kokkonisd/pression/Working sessions reports/20170329.odt

Compte rendu de la séance de projet 29/03/2017

Retirer le mapping des valeurs des capteurs dans le code de l'arduino.

Amélioration de la Tare et ajout d'une valeur minimale de "10" sur les capteurs lorsqu'ils sont au repos et non 0.

Permet de centrer le centre de gravité dans l'app et eviter les 0 bugués.

Redaction du rapport

Ajout de la documentation du logiciel (non écrite mais implémenté dans le programme PC)

Changement des fils des load sensors, remplacement par des plus grands et protection mécanique avec gaine thermo'.
