kokkonisd/pression/Working sessions reports/20170405.odt

Compte Rendu de la séance 05/04/2017:

Recherche des dimensions d'une plaque a poser entre les capteurs, le sol et la chaise. Dimensions retenues 65*65cm ou 60*60 cm à défaut.

Rédaction du rapport de projet.

Prise de photos pour le rapport de projet.
