kokkonisd/pression/Working sessions reports/20170322.odt

Compte-Rendu de la séance du 22/03/17

Pendant cette séance, on a fait un refactoring du code qui gère le chargement et l'enregistrement de la chaise : afin de pouvoir garder la même échelle en ce qui concerne la deadzone, on a introduit une nouvelle variable appelée "deadzone ratio", qui varie de 0 à 1 et représente la fraction de l'aire de la chaise occupée par la deadzone. On a modifié le code pour mettre à jour ce changement et on a vérifié que les méthodes save/load marchent bien sur l'application PC.

En ce qui concerne l'application Android, on a implémenté la fonction chargement de la chaise, en vérifiant que l'application peut donc charger des fichiers "chaise" crées par l'application PC (comme ça tous les fichier "chaise" sont interchangeables). Puis, on a ajouté un bouton "tare", pour pouvoir avoir accès à la fonction "tare" de l'Arduino par l'application Android.

Au niveau de l'Arduino, on a implémenté la fonction "tare" pour l'USB et le Bluetooth, en vérifiant qu'elle marche bien sur toutes les plateformes (PC & téléphone portable).

On a aussi commencé a travailler sur les supports des capteurs pour les placer sous une chaise; on est en train de construire un prototype sur AutoCAD. On a déjà fabriqué des petit support en bois MDF qui permettent de poser une chaise sur les capteurs.

Finalement, on a testé l'application en mettant une chaise sur le matériau, et en posant un sac sur la chaise. On a constaté que les capteurs et l'application répondent bien aux changements de la position du sac, et qu'on obtient bien le résultat voulu.

Objectifs pour la prochaine séance:

- Ajuster les paramètres des capteurs dans l'Arduino (mapping des valeurs)

- Tester la chaise avec une personne
