kokkonisd/pression/Working sessions reports/20170315.odt

Compte rendu de séance de projet 8 15/03/2017:

Pendant cette séance, on a réussi à connecter le dernier amplificateur au load sensor et à l'Arduino; on a testé les quatre load sensors ensemble et ils marchent bien avec le logiciel.

On a aussi corrigé quelques bugs dans les méthodes d'enregistrement et de chargement de l'objet Chaise, mais comme la sérialization d'un objet Java avec l'application PC ne permet pas de charger l'objet dans l'application Android, on a decidé de changer le protocole d'enregistrement : les objets Chaise vont être sauvegardés dans des fichiers .txt, ce qui permet de les charger partout.

Finalement, on a mis à jour le code de l'Arduino pour prendre en compte le dernier capteur et pour négliger les valeurs négatives (bruit) envoyés par les capteurs.
