kokkonisd/pression/Working sessions reports/20170215.odt

Compte rendu scéance 6 15/02/2017

Ajout des fonctionnalités de deadzone et sauvegarde et chargement de l'objet chaise. A demandé beaucoup de reflexion sur tableau blanc.
