kokkonisd/pression/Working sessions reports/20170207.odt

Compte rendu séance de projet 5 07/02/2017

1. Ajoût de la fonction de paramétrage d'une "deadzone" dans laquelle on dit que la posture assise est correcte. Un cercle vert indique la zone de comfort. Les informations à propos de cette zone sont stockés dans l'objet Chaise conçu pour effectuer tout les calculs.
2. Corrections de bugs dans l'application Android. Amélioration des performances.
3. Modification du nom bluetooth du shield Arduino (BTProjetDI6)

Objectif pour la prochaine séance:

Terminer l'implémentation du paramétrage de la deadzone et implémentation de la notification en cas de sortie de la deadzone.

Améliorer l'interface graphique de l'application bluetooth.

Si le temps le permet:

Améliorer l'autonomie de l'arduino (mise en veille, coupure du bluetooth...)
