kokkonisd/pression/Working sessions reports/20170125.odt

Compte rendu séance de projet 3 25012017

1. Visite du PAF de 9h à 9h30 OK
2. Démontage d'une balance électronique pour étudier les capteurs de charges (load sensors) OK
3. Mesure des valeurs de resistances du capteur de charge => 1kOhm OK
4. Fabrication d'un pont WheatStone avec un capteur de force et 2 resistances d'1 kOhm KO (impossible de verifier le fonctionnement sans amplificateur, oscillo et voltmetres pas assez précis pour mesure la ddp du pont wheatstone)
5. Modification du code de l'arduino pour permettre la reception de données via le port série (permettra d'envoyer des commandes pour contrôler l'arduino depuis le programme sur PC ou Android) OK
6. Ajout d'un shield bluetooth OK
7. Modification du code de l'arduino pour prendre en charge le Shield bluetooth OK
8. Transmission des données via Bluetooth vers l'ordinateur OK
9. Alimentation de l'arduino + shield via Power bank USB OK (autonomie énergétique et communication sans fils)

Objectif prochaine séance:

Démarrage du développement d'une APP android pour afficher la position du centre de gravité sur son smartphone

Amelioration du code du PC pour lancer la connexion via bluetooth depuis un Thread et eviter de freezer le main Thread

Ajouter la fonctionnalité de paramétrage de la chaise utilisé dans l'interface PC

Ajouter une fonction de sauvegarde de la position du centre de gravité optimale pour detecter la mauvaise assise en cas de déplacement de celui ci.
