kokkonisd/pression/Working sessions reports/20170118.odt

Compte rendu de la séance 2

Pendant la séance du 18/01/2017 nous avons fini la programmation d'une interface graphique qui permet la visualisation du centre de gravité d'une chaise à quatre pieds. Bien qu’on ait un seul FSR (senseur), on a pu tester l'application en soudant trois potentiomètres et en les connectant à l'Arduino, pour simuler ainsi les quatre pieds de la chaise. Puis, on a mis une vidéo sur GitHub (https://github.com/kokkonisd/pression/blob/master/Visualisation%20Program%20connected%20to%20Arduino.mp4) permettant d'envisager le changement de la position du centre de gravité de la chaise en fonction des valeurs du senseur et des potentiomètres.

Nous avons aussi fixé un protocole de transmission, suivant lequel l'Arduino transmet les valeurs des senseurs 1 à 4, séparés par un point-virgule (";"). Puis on a programmé en Java un parser, qui transforme la chaîne des caractères qu'on reçoit par l'Arduino en un tableau d’entiers qu'on peut exploiter pour calculer la position du centre de gravité.

En outre, l'interface graphique nous permet aussi de choisir un port de communication et de l'activer pour communiquer avec l'Arduino.

Nos objectifs sont désormais:

a. Améliorer l'interface graphique; on pourrait éventuellement implémenter des fonctionnalités supplémentaires, comme la possibilité de pouvoir renter les dimensions d'une chaise, puis les sauvegarder, et donc éviter de faire entrer les mêmes données plusieurs fois, ou bien utiliser le logiciel avec des chaises différentes

b. Commencer à travailler avec la shield Bluetooth de l'Arduino, pour établir la communication des donnés par Bluetooth.
