kokkonisd/pression/Working sessions reports/20170111.odt

Compte rendu scéance 1

Nous avons installé l'IDE Arduino et les pilotes de la carte Arduino OK!

Mise en place d'un Github pour partager le code et le projet OK!

Test de contrôle LED intégrée à l'Arduino OK !

Acquisition de données du capteur de pression et affichage dans le moniteur serie OK !

Reception en JAVA des messages série émis par l'Arduino et reception des messages emis depuis JAVA par l'Arduino avec la l'API JserialComm OK!

Nous allons donc pouvoir développer une application PC permettant de visionner les valeurs des capteurs de pression. Elle permettra de calculer la position du centre de gravité et en déduire la qualité de l'assise par rapport a la position recommandée. Les calculs se feront à partir de l'empatement de la chaise et des valeurs données par les capteurs de force. L'interface utilisateur devrait permettre de visualiser la position du centre de gravité afin d'ajuster facilement l'assise.

Recherche de capteurs de pression utilisable sur une chaise:

-Capteur de pression 50kg pour pese personne avec amplificateur pour le connecter à l'arduino.
