kokkonisd/pression/photos/photos_arduino/IMG_6746.JPG

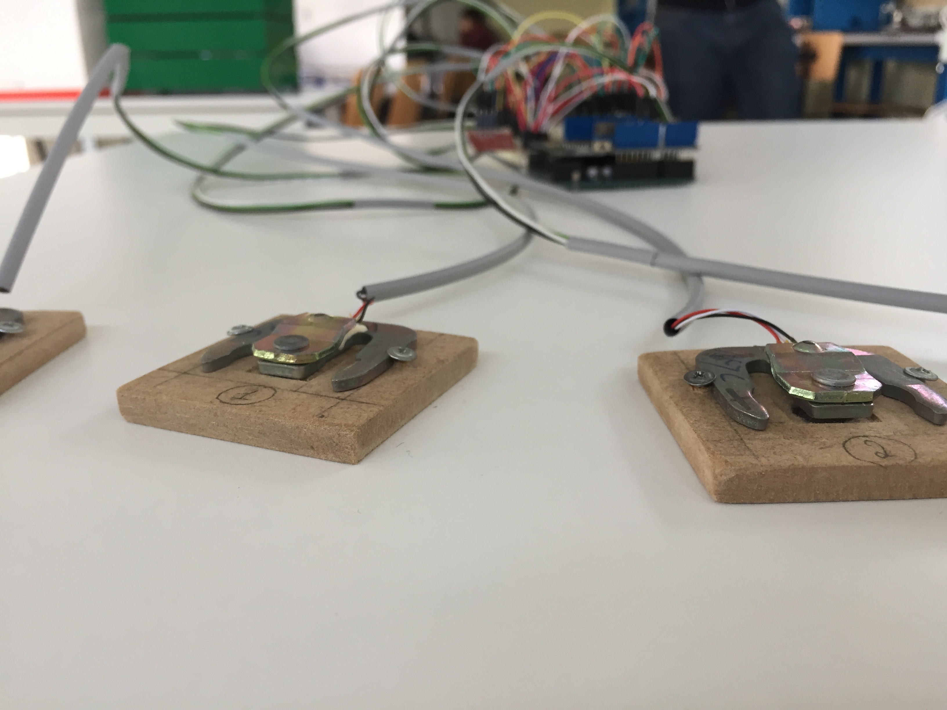
photos/photos_arduino/IMG_6746.JPG
