kokkonisd/pression/photos/photos_arduino/IMG_6747.JPG

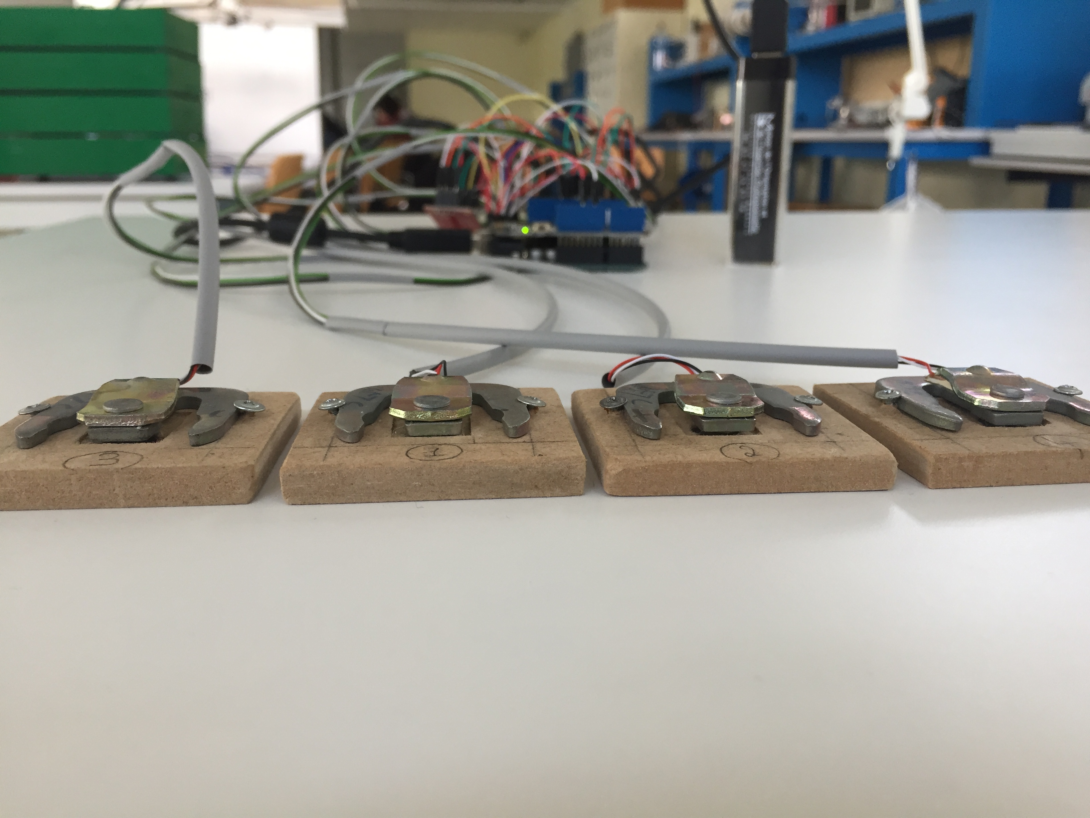
photos/photos_arduino/IMG_6747.JPG
