kokkonisd/pression/photos/photos_arduino/IMG_6750.JPG

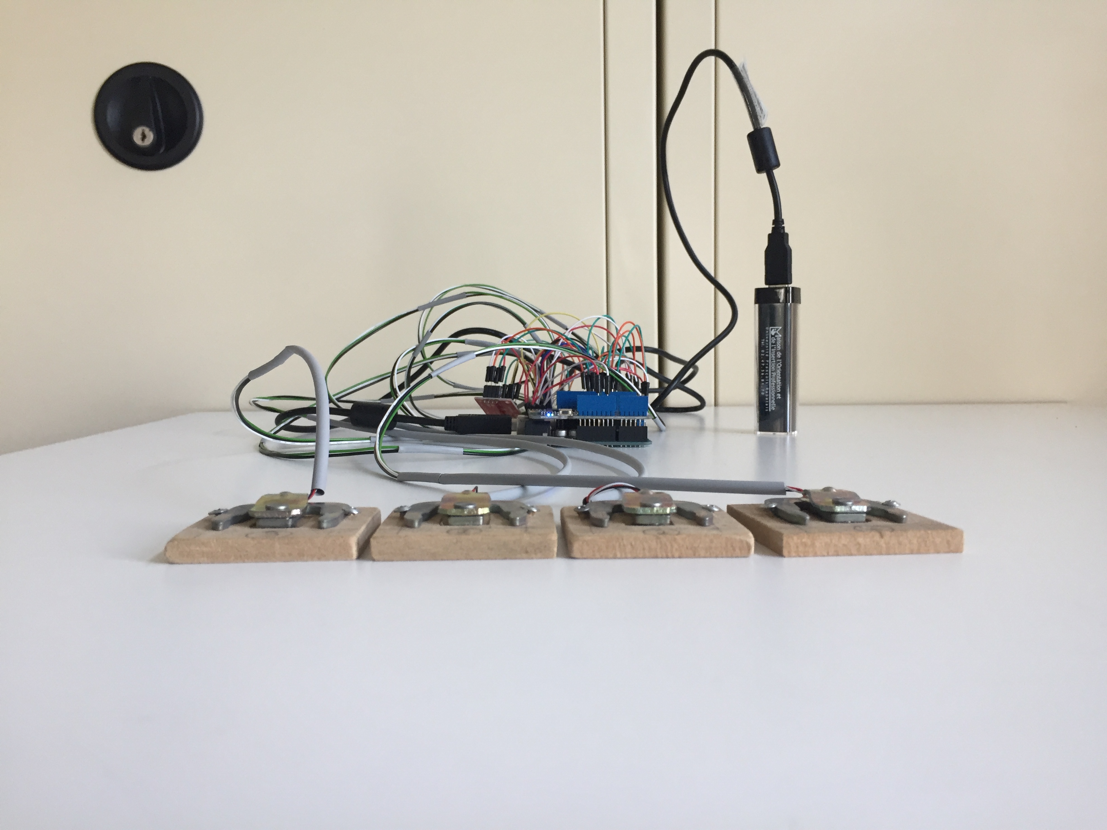
photos/photos_arduino/IMG_6750.JPG
