kokkonisd/pression/photos/photos_arduino/IMG_6751.JPG

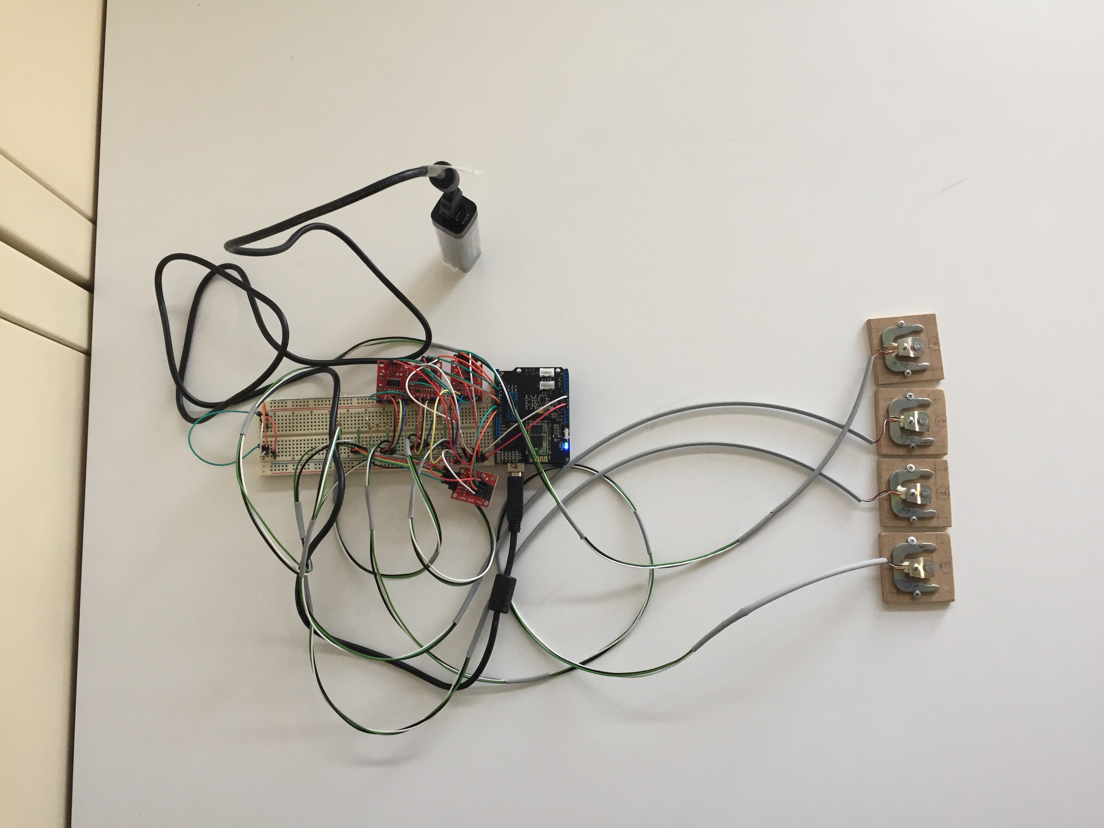
photos/photos_arduino/IMG_6751.JPG
