kokkonisd/pression/photos/photos_arduino/IMG_6752.JPG

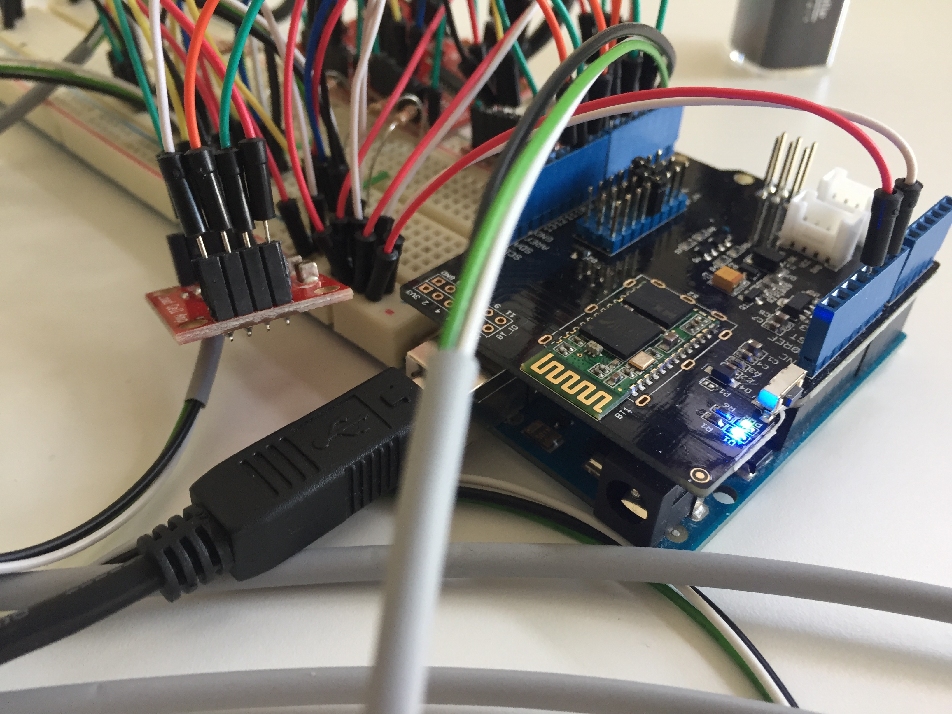
photos/photos_arduino/IMG_6752.JPG
