kokkonisd/pression/photos/photos_arduino/IMG_6755.JPG

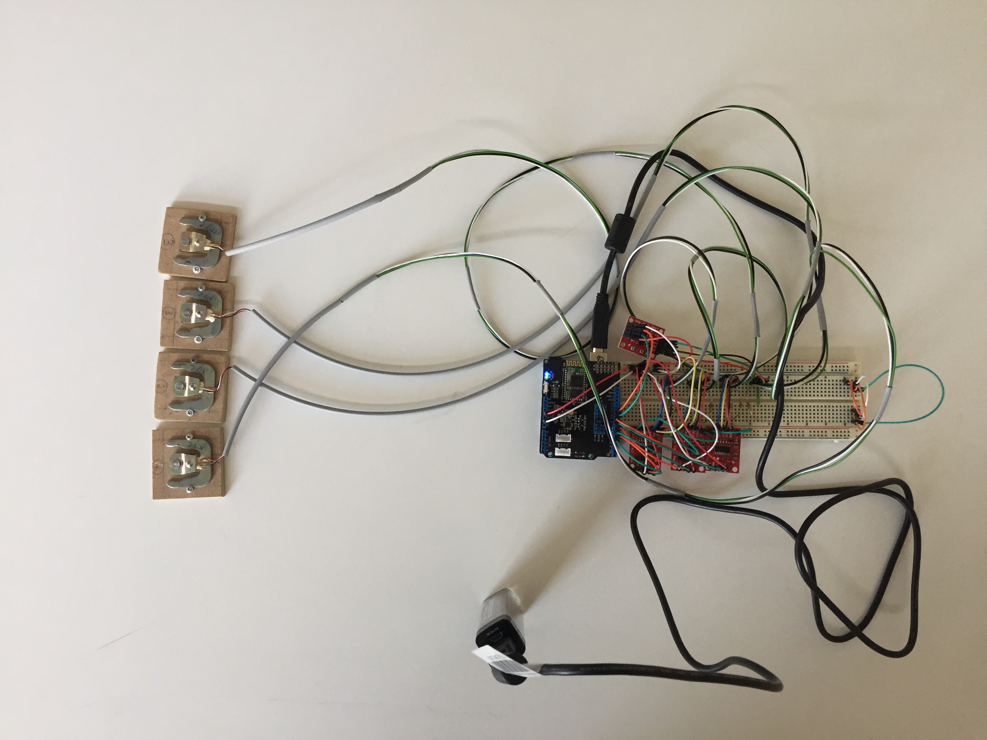
photos/photos_arduino/IMG_6755.JPG
