kokkonisd/pression/photos/photos_arduino/IMG_6756.JPG

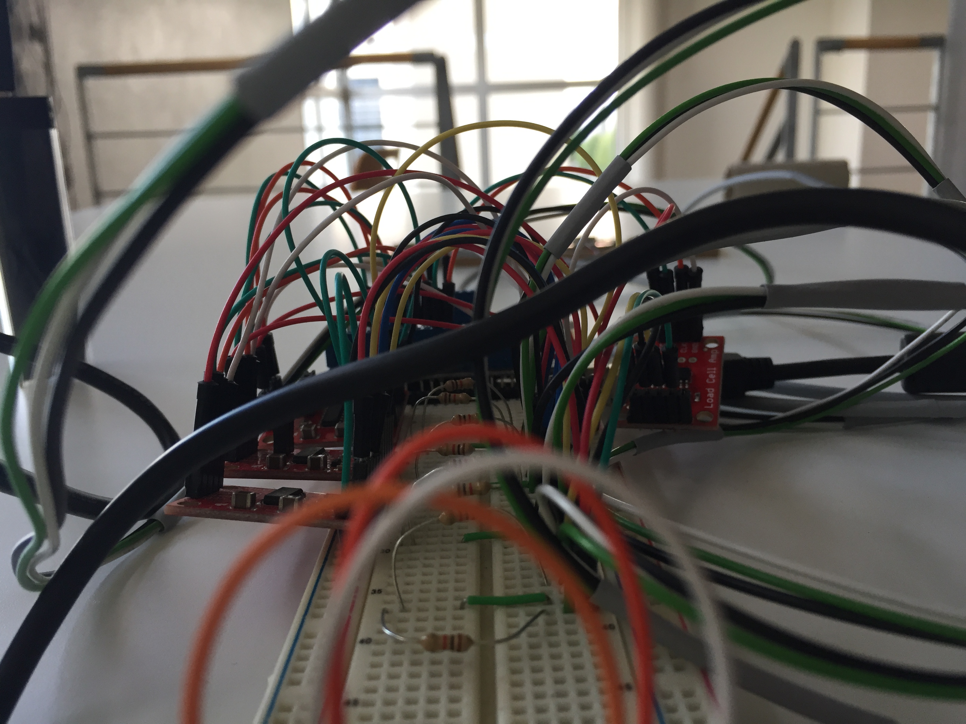
photos/photos_arduino/IMG_6756.JPG
