kokkonisd/pression/photos/photos_arduino/IMG_6757.JPG

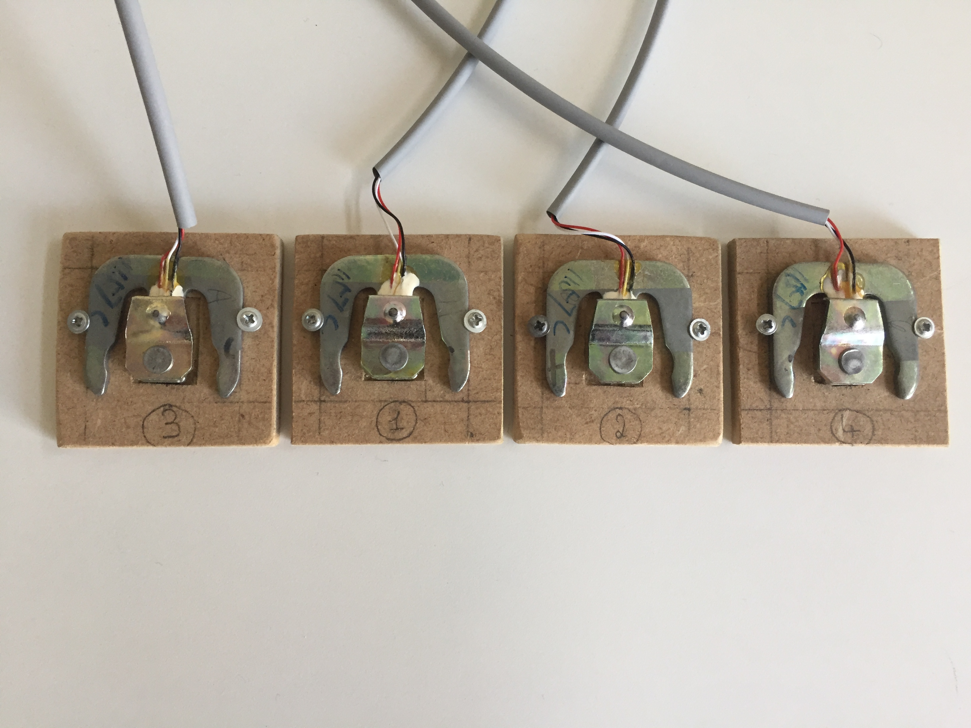
photos/photos_arduino/IMG_6757.JPG
