kokkonisd/pression/photos/photos_arduino/IMG_6758.JPG

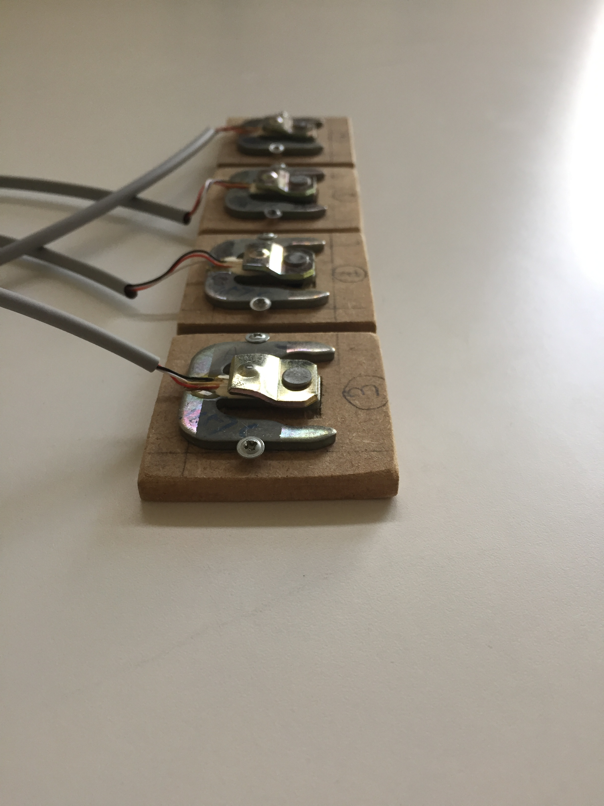
photos/photos_arduino/IMG_6758.JPG
