kokkonisd/pression/project.JPG

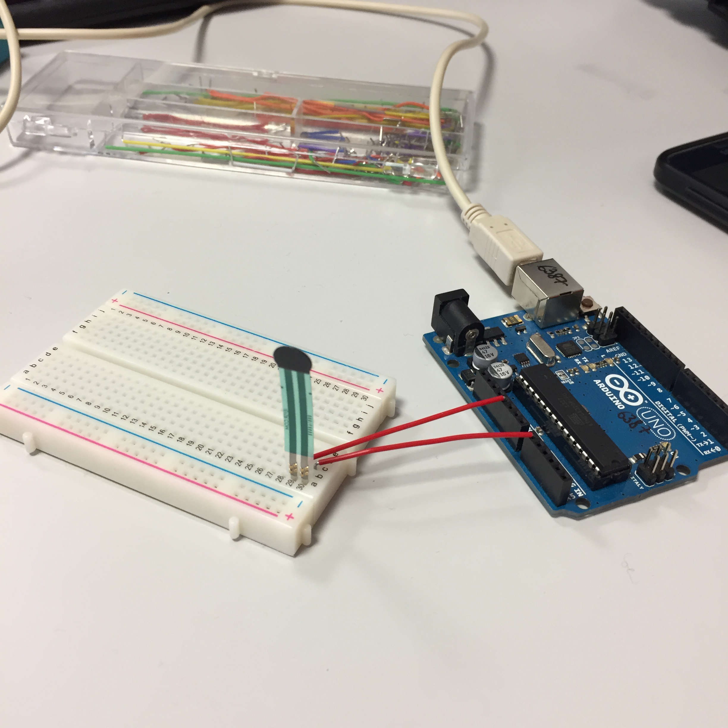
project.JPG
