kokkonisd/pression/Soutenance/images/Arduino_v1.jpg

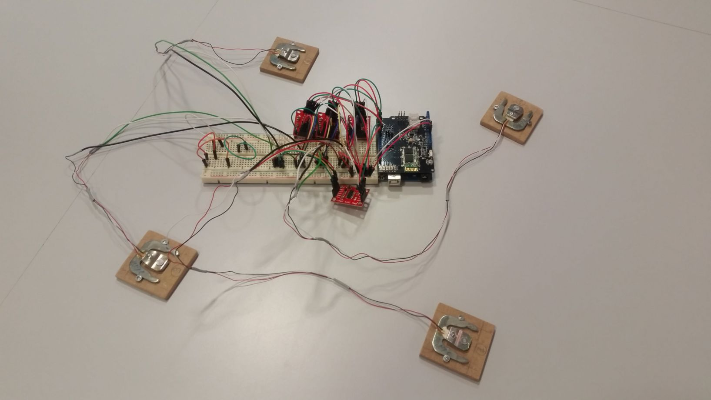
Soutenance/images/Arduino_v1.jpg
