kokkonisd/pression/Soutenance/images/Arduino_v1_bat.jpg

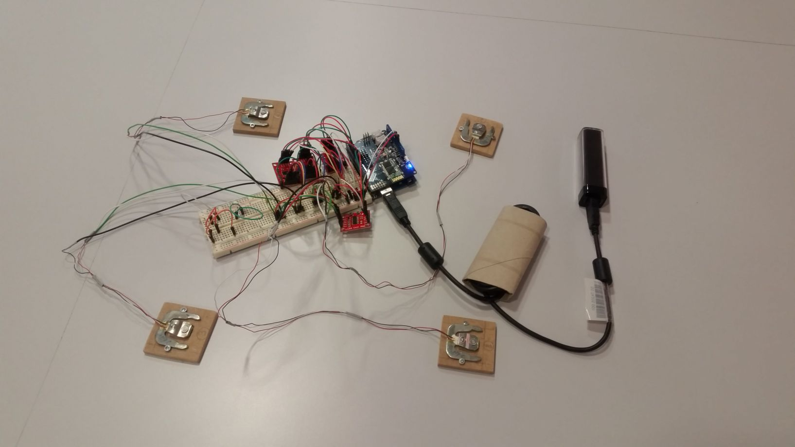
Soutenance/images/Arduino_v1_bat.jpg
