kokkonisd/pression/Soutenance/images/Arduino_v1_bat_ch.jpg

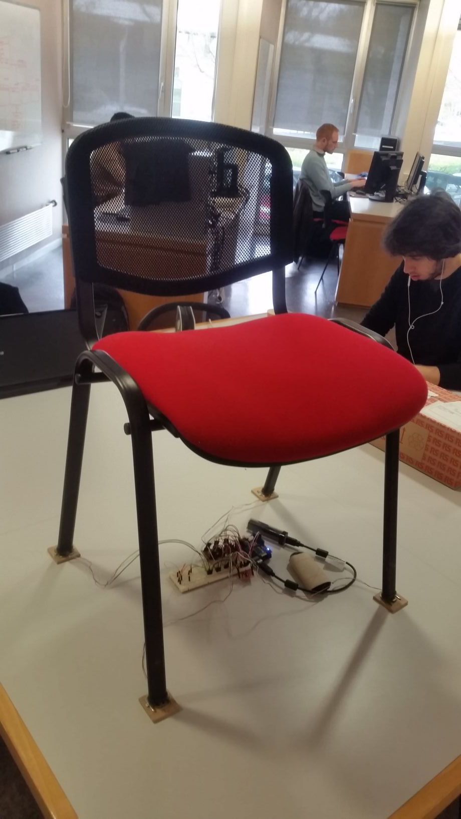
Soutenance/images/Arduino_v1_bat_ch.jpg
