kokkonisd/pression/Soutenance/images/jpanel1.PNG

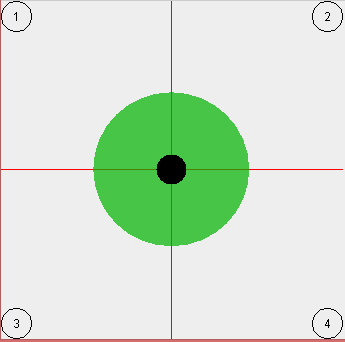
Soutenance/images/jpanel1.PNG
