kokkonisd/pression/Soutenance/images/jpanel3.PNG

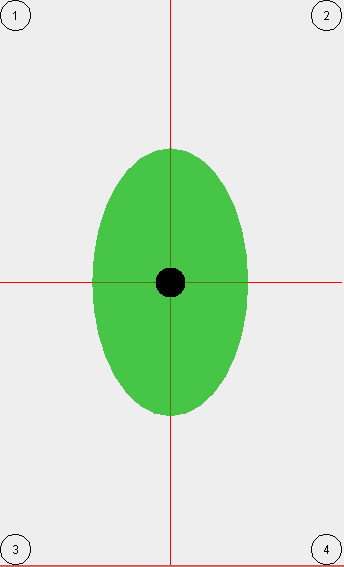
Soutenance/images/jpanel3.PNG
