kokkonisd/pression/Soutenance/images/mesure_de_consommation1bis.JPG

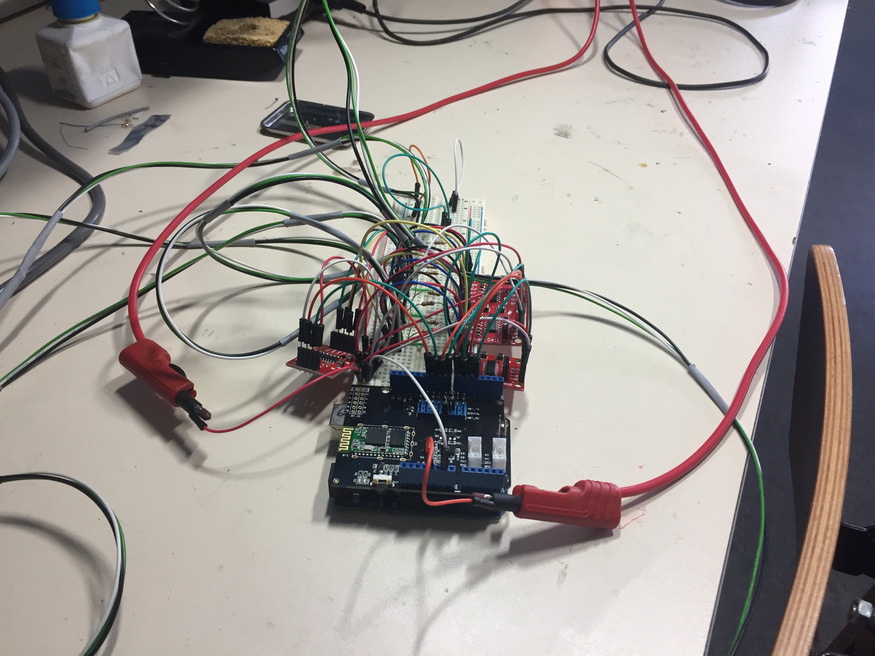
Soutenance/images/mesure_de_consommation1bis.JPG
