kokkonisd/pression/Soutenance/images/poster_1.jpg

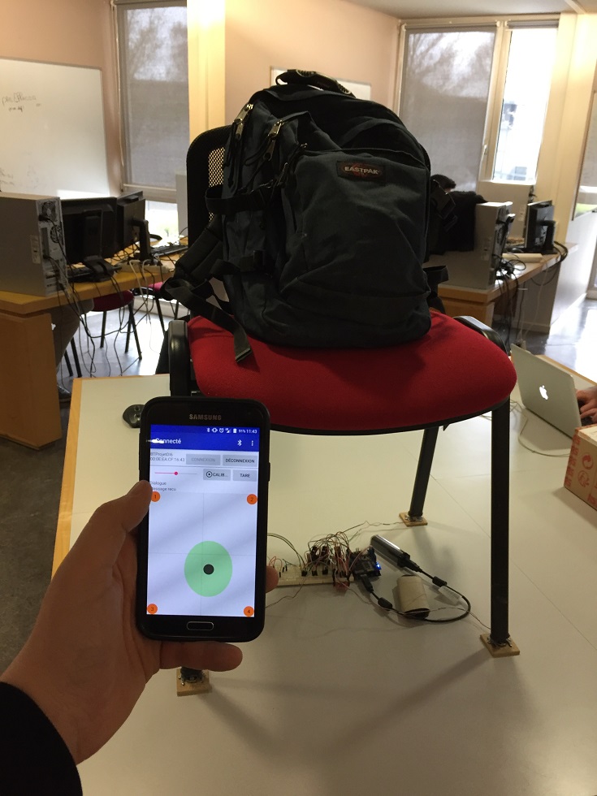
Soutenance/images/poster_1.jpg
