kokkonisd/pression/Soutenance/images/poster_2.jpg

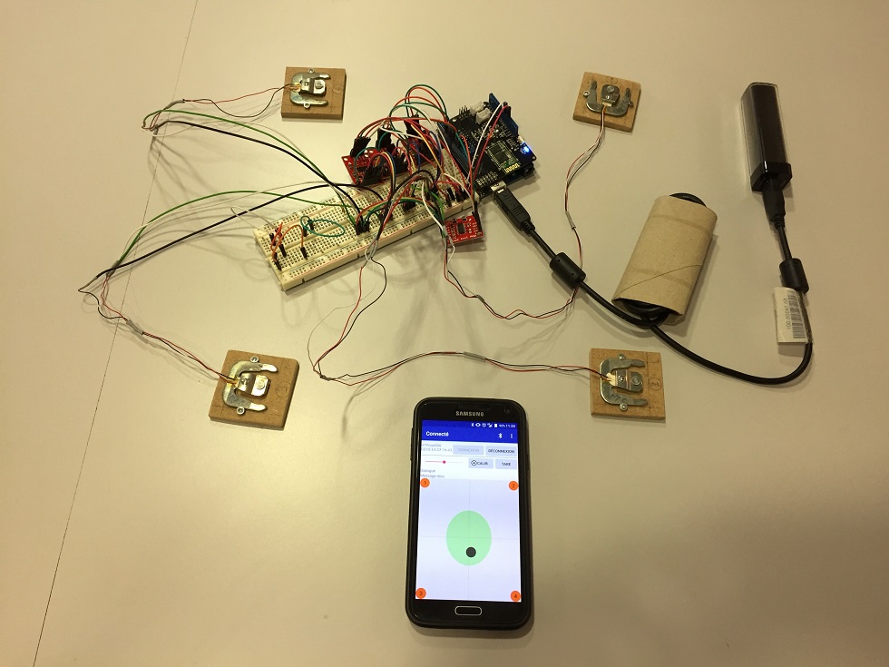
Soutenance/images/poster_2.jpg
