kokkonisd/pression/Soutenance/images/poster_3.JPG

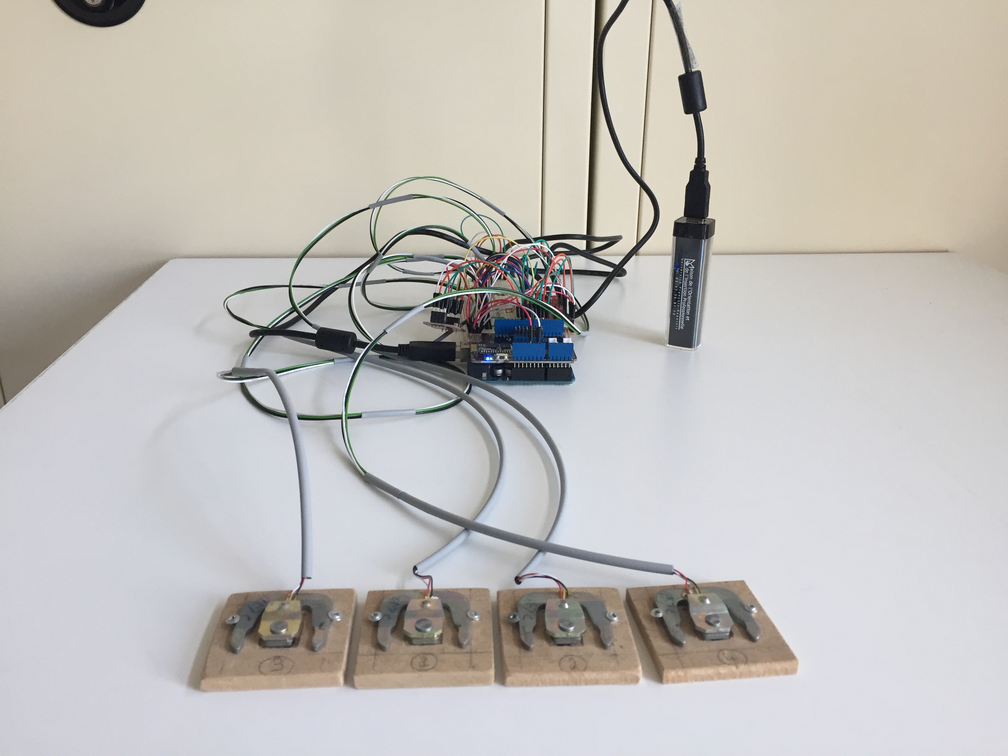
Soutenance/images/poster_3.JPG
