kokkonisd/pression/Soutenance/images/refs.png

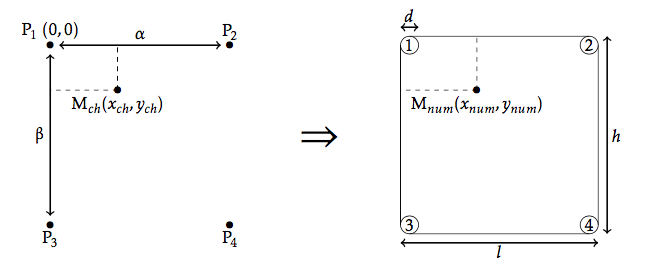
Soutenance/images/refs.png
