kokkonisd/pression/Soutenance/images/rxtx.jpg

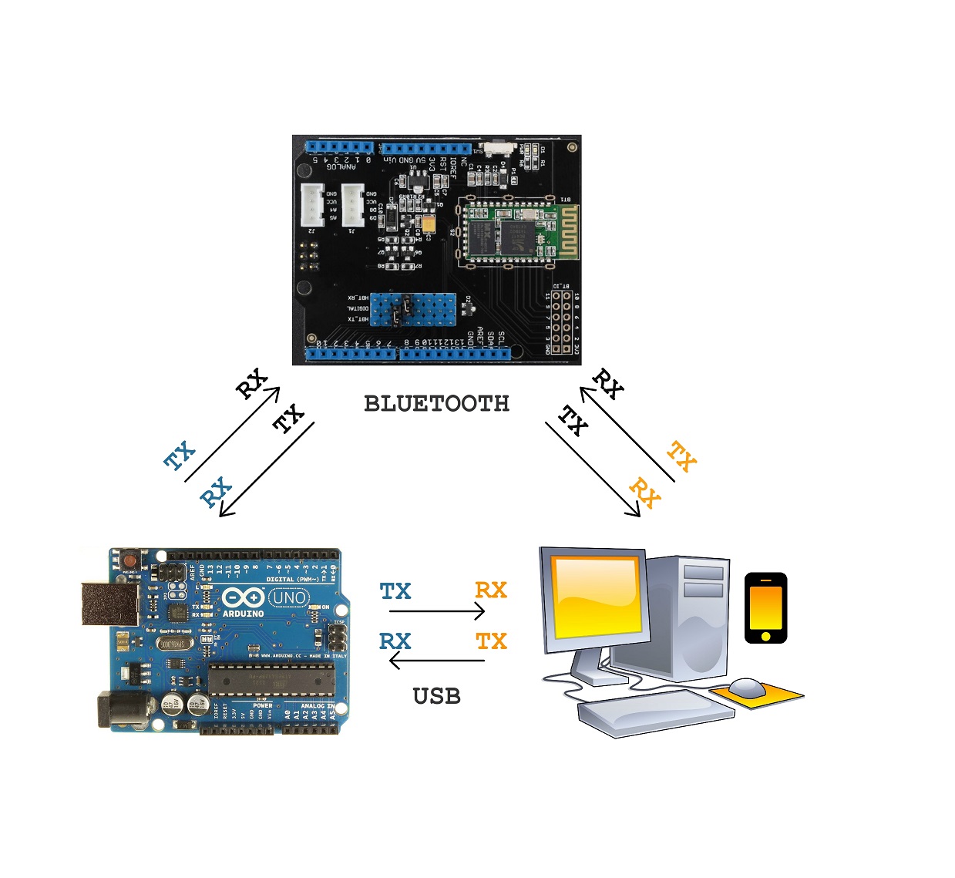
Soutenance/images/rxtx.jpg
