kokkonisd/pression/Soutenance/images/screenshot_android2.png

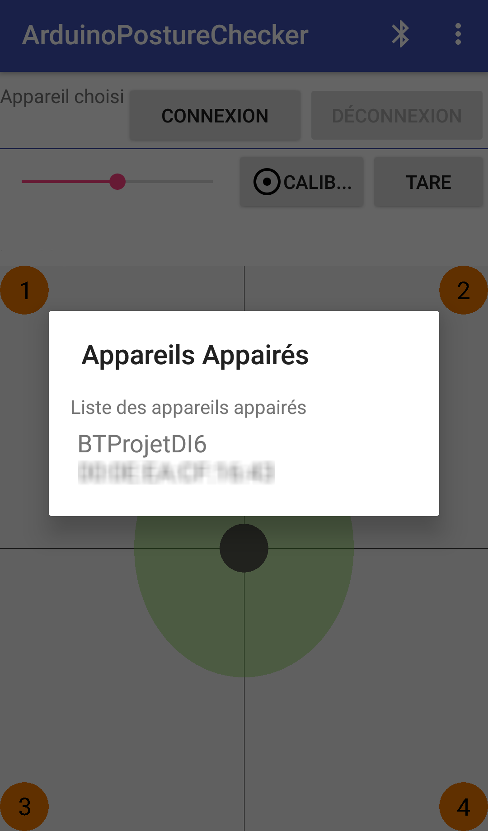
Soutenance/images/screenshot_android2.png
