kokkonisd/pression/Schematics and Datasheets/Config 1 one Load sensor arduino wiring using HX711.png

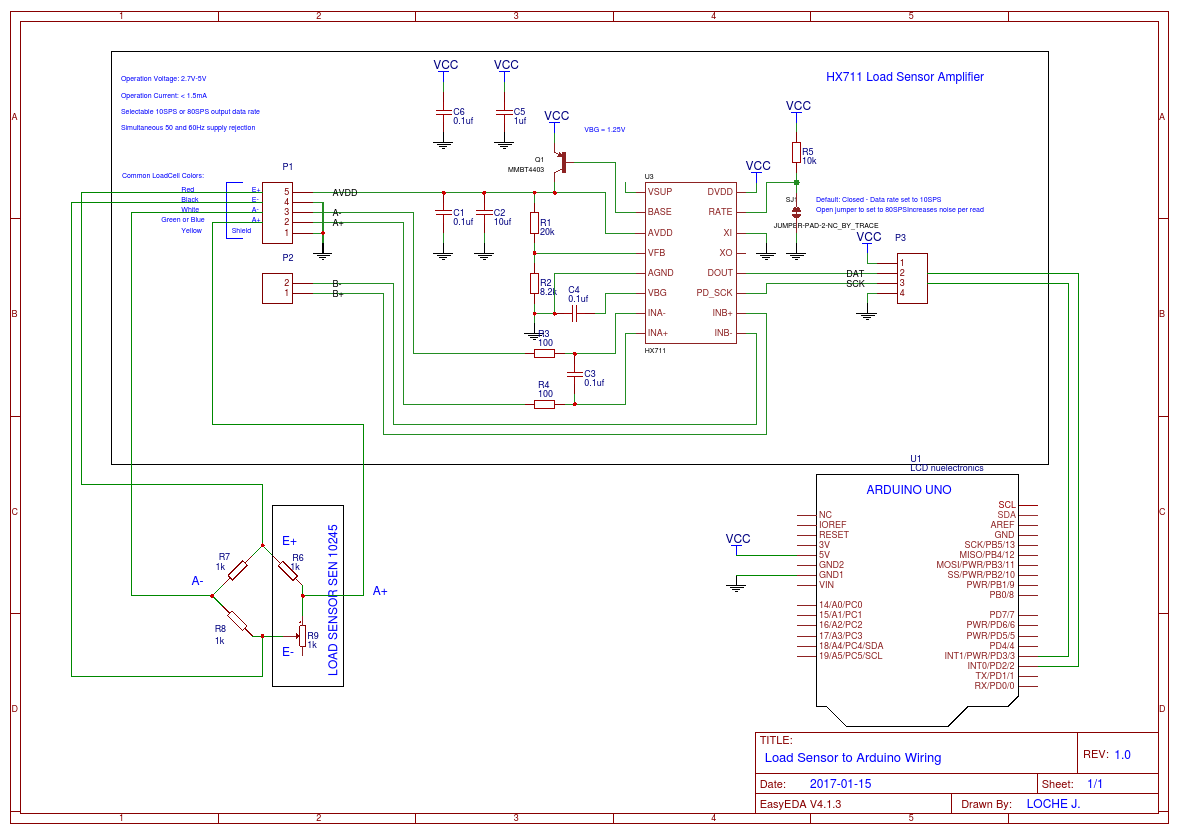
Schematics and Datasheets/Config 1 one Load sensor arduino wiring using HX711.png
