kokkonisd/pression/Schematics and Datasheets/Config 2 two Load sensors arduino wiring using HX711.pdf

## VCC VCC

## VCC 1uf

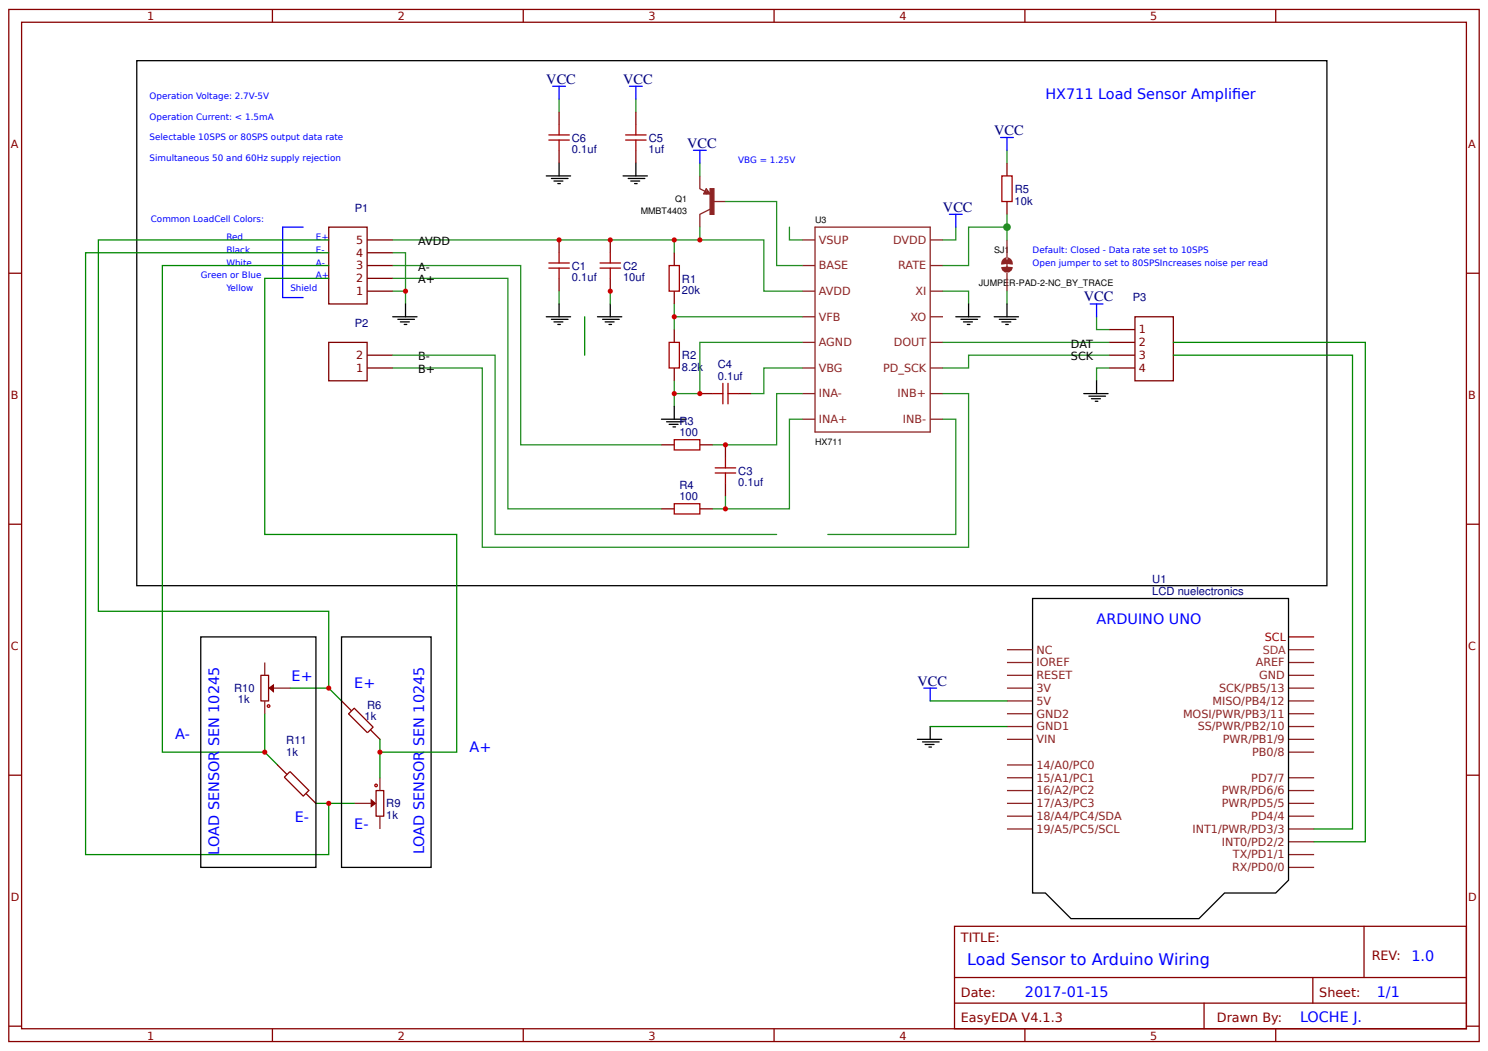
[picture p50: page 1]

Selectable 10SPS or 80SPS output data rate

Default: Closed - Data rate set to 10SPS
Open jumper to set to 80SPSIncreases noise per read
