kokkonisd/pression/(commit log)

2017-01-11 Add .c file to use with arduino
2017-01-12 Added Eclipse Project ArduinoPressionChair
    Contains the whole eclipse project with a fex classes to do basic stuff
    ilke calculating a baycenter or center of mass
2017-01-15 Add Load sensors wiring using HX711 and Arduino
    Schematics made with EASYEDA online by loche37.
2017-01-15 2 two new schematics and updating shopping list
2017-01-16 Wrote comm parser to parse data coming from the arduino
2017-01-16 Added bug testing to Arduino parser
    [ComInterface.java]
2017-01-16 Made minor improvement on the arduino parser, updated the tests to use the unit testing module
2017-01-17 Added random sensor value to test class
    visualization of changing position of center of gravity
2017-01-18 Updated Arduino code to transmit formatted data
2017-01-18 Added Arduino code sketch
2017-01-18 Cleaned up Arduino code
2017-01-18 Small fixes on the documentation of the Arduino code
    [ReadingSensorPressure.ino]
2017-01-25 Added data length verification to Arduino parser
2017-01-25 Refactored Arduino code for bluetooth use
2017-01-25 Fixed Arduino bugs
2017-01-25 Modified classes to add new functionnalities.
    -Added possibility to send data to arduino
    -Added a button to do that
    -Updated Arduino code to handle the bluetooth Shield
    -Updated Arduino code to handle receiving character A
2017-02-06 Added Session report, arduino program update and few code testings
2017-02-06 Minor changes to Arduino Code
2017-02-06 Added ArduinoSketch to configure Bluetooth module
    Also changed BT module name from "HMSoft" to "BTProjetDI6"
2017-03-08 Added New arduino sketch to use HX711 amps
2017-03-12 Modified code to add tare on 'A' received, changed timer positionning so that it resets after doing work and not before
    [ArduinoPostureLoadSensors.ino]
2017-03-12 Added a video showing android app and load sensors
2017-03-15 Added an additionnal sensor to the arduino code
2017-03-15 Added a paragraph about the arduino
2017-03-22 Updated Tare on 'A' received in arduino code
2017-03-29 Remove sensor values mapping to improve the measuring precisions
2017-03-30 "Comment determiner la postion d'une personne" completed
2017-03-30 Added text to the Arduino Section
2017-04-03 Added a section describing the Arduino code, edited .gitignore
2017-04-05 Added photos about the arduino
2017-04-05 Translated button names and changed layout a bit
2017-04-26 Added cost estimation part
    [Estimation de la consommation electrique.ods]
2017-05-07 Changes to the Arduino code to be more accurate
